TomasK1234/chess-robot-arm/docs/arm-design-plan.md

# Arm design plan

The staged plan for the mechanical design. Each stage ends with a check that must pass before moving on, and an export through the Fusion-to-GitHub add-in. Numbers are design targets until the real parts are measured.

## Approach

- **One master design.** `arm_layout` holds the user parameters, so every printed part becomes a component inside it, driven by those parameters. The servo and bearing models are inserted as linked reference components. The work in `base_mount` gets folded into the pedestal component. One document means one set of parameters and one place to check clearances.
- **Design from the gripper back to the base.** Each stage carries everything after it. The gripper and Z axis set the height of link 2, which sets link 1, which sets the pedestal height. That is why the pedestal is paused until the gripper and Z axis exist, even though work on it had started.
- **Shared baseboard.** The arm and the chess board mount on one laser-cut baseboard (6 mm plywood, MDF or acrylic, about 519 x 544 mm). The pedestal bolts to it, and an engraved outline or locating strips put the board in the same place every time. The arm cannot tip over (with roughly 330 g reaching about 300 mm out, a free-standing base would need about 1 kg of ballast). The board also stays registered to the arm, so square calibration and camera calibration survive being bumped. Check the laser cutter's bed size; the baseboard can be split in two with a joining plate if needed.
- **Test the riskiest part first.** Before printing the whole arm, print one joint (bearing, servo and hub) and bench-test it with the servo driver.

## Stage 0: buy the reference parts (ordered November 2026)

Hole spacing, horn shape, shaft splines and bearing hole patterns aren't in the listings. Designing mounts around guesses means reprinting. These parts are cheap, so buy them now and measure them.

| Part | Qty | Why now |
|---|---|---|
| MTR7 servo (MG995 class) | 3 | Mounts, horns and body size for the shoulder, elbow and Z axis. The spare was dropped from the order. |
| MTR11 mini servo (SG90 class) | 1 + 1 spare | Gripper drive |
| 3 inch lazy-susan bearing | 2 | Hole pattern, plate thickness and actual play (shoulder and elbow, no spare) |
| Puecrof board and Staunton set (measured November, see design notes) | 1 | King height, neck heights and diameters drive the gripper and the whole vertical stack. Knight measured with a ruler |

Measure with calipers: servo body length (without tabs), tab-to-tab length, mounting hole spacing and diameter, the height from the tab face to the shaft top, the horn hole pattern, and the shaft offset from the body centre. On the bearing: the hole positions on both plates, and how much it tilts under a light hand load. For each piece type: total height, neck height, the smallest neck diameter, and the widest part above the neck.

## Stage 1: upgrade the master layout (done 2026-10-30)

- Added parameters for the piece dimensions (EST), the gripper envelope, the bearing, the vertical stack, the link print length, the shoulder keep-out and the baseboard. See section 5 of the [design notes](design-notes.md#5-vertical-stack-second-pass-parametric).
- Added work planes at each level (`plane_lift`, `plane_shoulder_plate_top`, `plane_link1_bottom`, `plane_link1_top`, `plane_link2_bottom`), and a `baseboard` sketch with the shoulder keep-out circle.
- `pedestal_height` is now derived from the stack, so the shoulder servo reference moved up to 95.7 mm.
- Joint axes at the elbow and wrist are deferred to Stage 7, when the link components exist.
- **Check passed:** with `board_size` at 400 mm and `king_height` at 85 mm, every level, the baseboard and the servo position updated, and the timeline stayed healthy. Values restored to 350 mm and 76 mm afterwards. At 400 mm, `link_overall_length` becomes 344 mm, too long for the Mark 2, which shows the length check is worth keeping.

## Stage 2: gripper

- **Concept:** a parallel gripper. The MTR11 turns a centre pinion that drives two opposed racks, so both jaws move together and stay centred on the piece. V-notched jaw pads self-centre on round necks.
- **Requirements:** the opening clears the widest piece head with margin. The open jaws fit between neighbouring pieces at grip height (squares are 40.125 mm; jaws open to at least 29 mm (knight head 25 mm in any orientation) and close to 8 mm or less). The grip lands on the neck of every piece type, including the knight.
- **Check:** in CAD, the open jaws clear the neighbouring pieces on a full board. Then print and test on real pieces.

## Stage 3: Z axis

- **Concept:** the servo turns a pinion driving a vertical rack on the gripper carriage. Two steel guide rods with printed or bronze bushings guide the carriage.
- **Travel:** from the grip height down at the board, up to where a carried piece's base clears the king by `lift_height` plus margin.
- **Decision for this stage:** keep an MTR7 (one servo type, already chosen) or use a lighter metal-gear micro servo (about 13 g instead of about 55 g at the tip). The bearings take the weight, so this mostly affects droop and inertia, not servo torque.
- **Check:** at the bottom of the travel, the gripper reaches grip height on the shortest piece (a pawn). At the top, the carried piece clears the king.

## Stage 4: forearm (link 2) and elbow

- **Link manufacture (lab printers).** Each link is 211.8 mm between axes. Allowing 40 mm beyond each axis to bolt to the bearing plates, a link is 291.8 mm long overall.
  - Prototype links: PLA or PETG on the Ultimaker S5 (330 x 240 x 300 mm build volume). Fast, cheap and easy to reprint.
  - Final links: Onyx with continuous carbon fibre on the Markforged Mark 2 (320 x 132 x 154 mm). Much stiffer and lighter at the same size. A 291.8 mm link fits. Keep the overall length to 315 mm or less, or bolt on separate end hubs.
  - Design implication: continuous fibre is laid in flat layers, so the links should be plate-like parts printed lying flat, with the fibre running along the length. Vertical features such as the servo pocket go on the hubs.
- **Elbow:** the servo mounts on the end of link 1 with its shaft up. Link 2 rides on the second bearing. The servo horn drives link 2 through a coupling with slight radial float, so the servo shaft and the bearing don't fight over the axis.
- **Check:** link 2 and the Z carriage clear link 1 and the shoulder hub at the full 160° fold.

## Stage 5: link 1 and shoulder hub

- The same construction as link 2. The shoulder hub couples the shoulder servo horn to the link and the bearing's rotating plate.
- **Check:** the full 4° to 130° shoulder sweep has no collisions.

## Stage 6: pedestal, base and electronics bay

- The pedestal height now follows from the stack. The shoulder servo hangs under the top plate. The pedestal stands on the baseboard, which is `board_thickness` (24 mm) below the playing surface, so its real height to the servo body base is `pedestal_height_above_baseboard` (112.7 mm).
- The lowest 24 mm of the pedestal sits beside the wooden board, so on the board side it must stay within `board_edge_clearance` (24.5 mm) of the shoulder axis.
- On the board side, the structure stays within about 54 mm of the shoulder axis, so the gripper can reach the nearest squares.
- An electronics bay in the base holds the Pico and the PCA9685 Featherwing side by side (they are joined by jumper wires, not stacked), the barrel jack and the capacitor. Neither board's mounting holes suit the M3/M4 kit (M2 for the Pico, M2.5 for the Featherwing), so plan printed clip-in posts. Plan cable routes up the arm with slack loops at each joint.
- **Check:** fasteners can be reached with tools, and wires don't snag across the full joint ranges.

## Stage 7: motion check in CAD

- Add revolute joints at the shoulder and elbow and a slider for Z. Drive the arm to the far corner, the board centre, the nearest squares and the capture area.
- **Check:** no interference anywhere. The clearance zones from the design notes stay clear.

## Stage 8: prototype

1. Print the shoulder joint and bench-test it through its range.
2. Print the remaining parts and assemble.
3. Measure the real play at the tip and compare it with the precision estimates in the design notes.
