TomasK1234/chess-robot-arm/hardware/cad/arm_layout.step

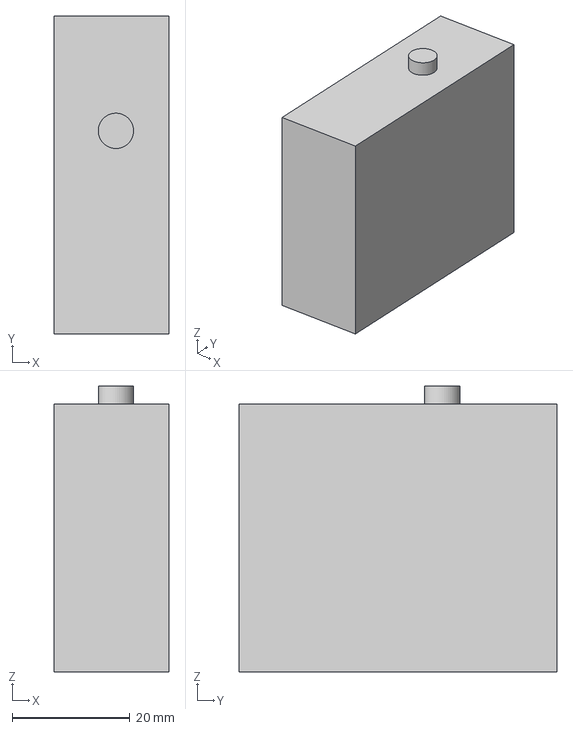
[picture p4: CAD file, 2026-11-10]
hardware/cad/arm_layout.step
19.5 x 54.0 x 48.5 mm
