TomasK1234/chess-robot-arm/(list of files, cad)

Other CAD files:
hardware/cad/arm_layout.f3d
hardware/cad/arm_layout.stl
