TomasK1234/chess-robot-arm/CHANGELOG.md

# Changelog

## 2026-11-10 00:54:32 - arm_layout
- **Branch:** `main`
- **Commit Message:** "Updated design"
- **Files Updated:**
  - `hardware\cad\arm_layout.f3d`
  - `hardware\cad\arm_layout.step`
  - `hardware\cad\arm_layout.stl`

---

## 2026-11-09 18:21:35 - arm_layout
- **Branch:** `main`
- **Commit Message:** "Updated design"
- **Files Updated:**
  - `hardware\cad\arm_layout.f3d`
  - `hardware\cad\arm_layout.step`
  - `hardware\cad\arm_layout.stl`

---

## 2026-10-30 17:40:53 - arm_layout
- **Branch:** `main`
- **Commit Message:** "Updated design"
- **Files Updated:**
  - `hardware\cad\arm_layout.f3d`
  - `hardware\cad\arm_layout.step`
  - `hardware\cad\arm_layout.stl`

---

## 2026-10-22 10:19:32 - arm_layout
- **Branch:** `main`
- **Commit Message:** "Updated design"
- **Files Updated:**
  - `hardware\cad\arm_layout.f3d`
  - `hardware\cad\arm_layout.step`
  - `hardware\cad\arm_layout.stl`

---
