TomasK1234/chess-robot-arm/docs/build-log.md

# Build log

Newest entries first. Each entry records what was done and what was decided, with the reason.

## November 2026

### Controller changed to a Raspberry Pi Pico, power wiring planned

- The servos (3 MTR7, 2 MTR11), the capacitor and the DC socket arrived. The socket fits the supply's plug. Nothing has been measured yet.
- **The Featherwing cannot stack.** Photos showed that a previous owner fitted all its headers on the top face (a socket strip on the 12-pin side, pins on the 16-pin side), so nothing protrudes underneath. It is also the 8-channel board, not the 16-channel one the notes assumed. Its A0 and A2 address jumpers are bridged, which should make its I2C address 0x45.
- **Changed the controller from the Feather HUZZAH ESP8266 to a Raspberry Pi Pico WH.** With no stacking, a Feather-shaped board has no advantage, and the Pico costs about half as much. It will run MicroPython, because servo positions can be typed in and tried immediately during calibration.
- **Kept the Featherwing.** It distributes servo power, takes the servo plugs directly and produces steady pulses. Its step is 20 ms / 4096, about 4.9 µs (0.44°). Revisit only if a bench test shows the step size limits accuracy.
- **Connection:** four jumper wires between the Pico and the Featherwing (3.3 V, GND, SDA, SCL).
- **Power wiring.** The supply goes into the Featherwing's screw terminal, with the 1000 µF capacitor across it, and from there to the servos. The same terminal feeds the Pico's VSYS pin through a diode, and the Pico's 3V3(OUT) pin powers the Featherwing's logic. The Pico's own diode already stops the supply back-feeding a PC over USB; the added diode stops USB power flowing the other way into the servo rail when the supply is off. With only USB connected the servos are unpowered, which is the safe state for uploading code. This replaces the earlier plan of feeding the Feather's USB pin.
- **Ordering deferred.** The Pico, the jumper wires and the remaining small parts will be ordered together once the design is ready to print, to avoid paying for delivery more than once.

### Design review and baseboard height

- Reviewed the whole design before starting the gripper. The reach maths, the gripper clearance arithmetic and the power budget all checked out.
- **Moved the baseboard below the playing surface.** `board_thickness` had been measured but not used, so the baseboard was drawn at the same height as the squares. It is now on a new plane, `plane_baseboard_top`, 24 mm lower. The new parameter `pedestal_height_above_baseboard = pedestal_height + board_thickness` = 112.7 mm is the height the pedestal really has to be. Tested by setting `board_thickness` to 30 mm: the plane and sketch followed and the timeline stayed healthy. Restored to 24 mm afterwards.
- **Corrected the servo resolution estimate.** The notes assumed 1000 to 2000 µs covers 180°. Servos of this class usually need about 500 to 2500 µs for that, which doubles the number of steps: about 0.44° per step (about 3 mm at full reach), not 0.88°. To be confirmed on the real servos.
- Fixed stale numbers in the design plan and bill of materials (links 211.8 mm between axes and 291.8 mm overall, baseboard 519 x 544 mm, order quantities), and moved a CAD export entry from the hand-written changelog to the add-in's log.
- **Still open from the review:** the real landing accuracy is unknown until a servo is bench-tested (the gripper sizing assumes ±2 mm); the gripper has to be slim or long-fingered to reach a pawn beside a king; whether to use only the elbow-side capture strip; a series diode so the 5 V supply cannot back-feed a PC over USB; and the camera mount (lens about 450 to 650 mm above the board).

### Chess set measured, layout updated

- Measured the Puecrof set: 40.125 mm squares (321 mm playing area), 29 mm border (378 mm overall), 24 mm thick, 77 mm king. Neck heights run from 19 mm (pawn) to 42 mm (king); neck and head diameters are in the [design notes](design-notes.md#measured-chess-set-puecrof-november). The knight was re-measured straight across with a ruler (head 25 × 10 mm, neck 11 × 9 mm), because the paper-wrap method only works for round pieces.
- Updated `arm_layout`: `board_size` 350 → 321 mm, `king_height` 77 mm, grip heights 19 to 42 mm. Set `head_clear_dia` to 25 mm: with no wrist servo the jaw direction swings about 126° across the board, so the gripper must clear the knight's long side; a 29 mm jaw gap still leaves about 6 mm to the nearest neighbour. Links drop to 211.8 mm between axes (291.8 mm overall), Z travel to 105 mm and the underside of link 2 to 164 mm. The timeline rebuilds without errors.
- Added `board_border` and `board_thickness`. The baseboard now includes the border, which previously would have overhung the far edge by 9 mm. New check `board_edge_clearance`: the wooden board edge is only 24.5 mm in front of the shoulder axis, so the pedestal has to fit inside that.

### First parts order

- Ordered the Puecrof 15 inch folding chess set (40 mm squares, 3 inch king). The playing area becomes 320 mm, which keeps each link at about 291 mm overall, inside the Mark 2's 315 mm limit. A 45 mm-square board would have pushed the links past it.
- Ordered three MTR7 servos, two MTR11 servos (one spare for the gripper), two 3 inch lazy-susan bearings, a 1000 µF capacitor and a 2.1 mm DC socket.
- **Changed the power plan to a single 5 V 6 A supply** for both servos and logic. The planned 6 V 5 A supply cost £17.53 plus £24 delivery, a spare 12 V router adapter turned out to use a proprietary plug, and a 12 V supply plus a high-current buck cost about twice as much. Both servo types are rated from 4.8 V; the roughly 10 to 15 % torque loss is acceptable because the bearings carry the arm's weight. A 12 V supply with an XL4015 buck at 6 V is the fallback if the Z axis needs more torque.
- Deferred the Feather HUZZAH ESP8266, servo extension leads (lengths depend on cable routing), webcam, Z guides and grease. Dropped spare MTR7 and bearing.

## October 2026

### Layout, reach analysis and bearings

- Replaced the original articulated-arm plan with a **SCARA layout** after reviewing the alternatives, mainly because gravity no longer loads the main joints and the inverse kinematics become simple.
- Chose a **parallel gripper** with a real Staunton set, rather than a magnet.
- Built `arm_layout` in Fusion 360: a board sketch and a two-link arm skeleton, with every dimension driven by user parameters derived from `board_size`.
- Verified in the sketch that the arm reaches the far corner, the board centre and the nearest squares. The nearest squares need an elbow fold of about 160°, which makes clearance between the links the main thing to check in 3D.
- Worked out a first-pass vertical stack. The shoulder servo needs a pedestal, and the links need to sit high enough to carry a piece over a 76 mm king.
- Found that servo output shafts should not carry the arm's bending load, so **3 inch lazy-susan bearings** will carry the weight at the shoulder and elbow.
- Placed the shoulder servo reference in the layout, shaft on the shoulder axis and facing up.
- Settled the electronics direction: one 6 V supply for the servos, a buck converter for the logic rail, and WiFi so only a power cable reaches the arm.
- Created this repository.

## September 2026

### Scoping and parts

- Considered a drone, a desk-organising robot and a chess robot. Chose the **chess robot** for its bounded scope and clear demo, keeping the desk organiser as a possible second project on the same hardware.
- Dropped the gantry idea in favour of an arm that sits beside the monitor.
- Decided to keep the Adafruit PCA9685 Featherwing rather than move to an FPGA.
- Selected servos: three MTR7 metal-gear servos for the shoulder, elbow and Z axis, and one MTR11 mini servo for the gripper.
- Set up Fusion 360 user parameters and built placeholder models of both servos (`MTR7_reference`, `MTR11_reference`).
- Started `base_mount`, a plate around the shoulder servo.
