TomasK1234/chess-robot-arm/(commit log)

2026-10-22 Updated design
    [arm_layout.f3d, arm_layout.step, arm_layout.stl]
2026-10-30 Move changelog to docs, add arm design plan
2026-11-07 Switch to 5 V supply, update BOM with first parts order
2026-11-09 Design review: baseboard below playing surface, fix stale numbers and servo pulse range
    Baseboard is now drawn board_thickness (24 mm) below the playing surface on plane_baseboard_top, with pedestal_height_above_baseboard = 112.7 mm. Servo resolution corrected to about 0.44 deg per step (500 to 2500 us for 180 deg). Stale link lengths, baseboard size and order quantities updated in the design plan and BOM. CAD export entry moved from docs/CHANGELOG.md to the root CHANGELOG.md.
2026-11-13 Change controller to Raspberry Pi Pico WH and plan the power wiring
    The Featherwing is the 8-channel board with top-mounted headers, so it cannot stack. Controller is now a Pico WH running MicroPython, joined by four jumper wires. Logic power comes from the servo rail through a diode into VSYS. Bill of materials, READMEs, design notes, build log and changelog updated.
