TomasK1234/chess-robot-arm/(notices)

Notices in the files:
README.md:
License: MIT
